ZaddyHaze/HAZE/brand/stills/living-lattice-etsy-1x1.png

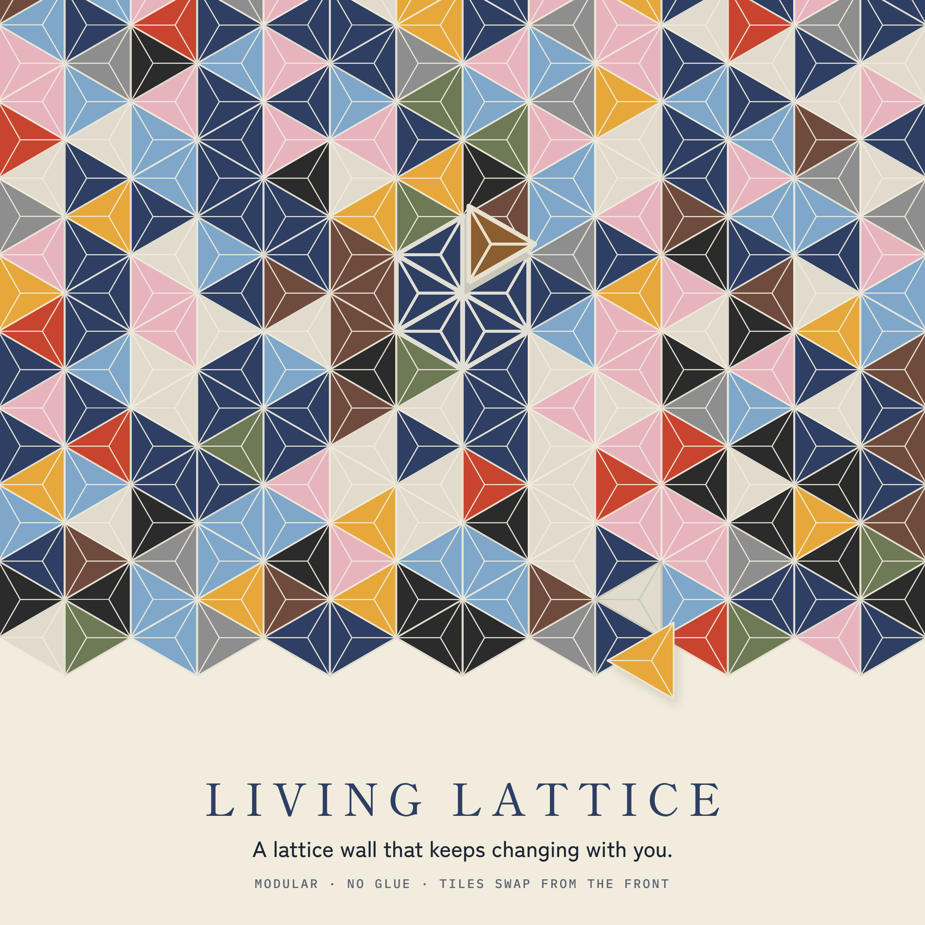
brand/stills/living-lattice-etsy-1x1.png
