ZaddyHaze/HAZE/HANDOFF.md

# Handoff to Cursor — state as of Oct 17, 2026

Brand: **Living Lattice**, designed by Travis Hergenreder. Start with `AGENTS.md`, then `docs/DESIGN.md`. Run `npm test` first: 101 checks should pass.

## What's done
- Builder (`index.html` + `src/engine.js`) with a simple panel of 7 choices and everything else under Advanced.
- Zigzag swappable tiles and half-lap "one solid panel" seams. All joints snap-fit; no glue.
- Round wall pucks hidden behind tile hubs. Frame standoffs hidden behind the frame bar (one per ~300 mm). Slotted shims.
- Optional floating frame with an LED channel (Advanced, or the "LED backlight" checkbox).
- Every part prints without supports, and no hardware shows from the front (enforced by `test/printability.test.js`).
- Test kit: lap, pegs, pucks, frame/standoff snap, shims.

- Per-tile inserts (asanoha / mitsukude / open), snap-in colored backers, color preview and two-color (AMS) export.

- Photo designer (first version): upload a picture, each triangle cell snaps to the nearest of 10 stocked colors (CIELAB), preview + chip counts + numbered `cell_color_map.svg` in the export.

- **Furniture fit** (Oct 17): "Made for" presets in the builder: cube-shelf insert (KALLAX-type, hidden spring clips, `mount = fit`) and headboards (Twin/Full/Queen/Cal King/King × 610 mm).
- **Cell accessories** (Oct 17, `src/accessories.js` + `npm run accessories`): magnet chip (sealed 8 × 2 mm magnet), cleat plug (universal accessory mount), bud vase holder (16 × 100 mm glass tube). Not in the builder yet.
- **Test kit as one Bambu project** (`npm run kit` → `cli/test-kit-3mf.js` + `cli/threemf.js`): 3 plates, named objects, magnet pause preset.
- **Panel 3MF export** (`cli/threemf.js`): CLI `generate.js` and the builder Export zip write `living_lattice_WxH.3mf` — 0.2 mm layers, 4 walls, mouse-ear brim on tiles/frame/backers, no brim on hardware, supports off, XY compensation 0. One plate per large part; hardware packed when it fits. Skip with `--no-3mf`. Letter-page wall templates when wall mount is on.
- **Website** (`site/`): `site/index.html` is the landing page (one `SITE_CONFIG` block at the top for email, checkout links, builder and starter URLs). `npm run build-site` writes `site/builder.html` (this builder as one file, with preset chips + LED halo on the stage). Builder opens on a preset from links or the chip bar: `builder.html?preset=queen` (also `#queen` inside a claude.ai artifact) — wall-led, cube, twin, full, queen, cal, king, starter. Starter pack: `site/living-lattice-starter-600x400.zip` (regenerate with `node cli/generate.js --set W=600 --set H=400 --set pat=asanoha --out out/living-lattice-600x400`).
- **Brand** (`brand/`): vector logo (stacked, horizontal, mark, one-color indigo/white, favicon + PNGs) and `animate.py`, which renders the logo-unfold video from the real geometry. Colors: indigo #2E3F63, wood #8A5E2E, paper #F1ECDD. Display font Shippori Mincho. Background everywhere is kinari #F1ECDD (design system tokens v3). Logo SVGs are outlined: `python3 brand/make_logos.py`. Social/listing stills: `python3 brand/stills_field.py stills/field-4x5.png 1080 1350 980 900` and `... field-1x1.png 2000 2000 1440 1380 0.8`, then `node brand/stills.js`.
- **Pattern-aware seams** (this branch): `latticeFit` + `assignCellTiles` so edges start on full/half cells and seams follow each pattern's grain.
- **Landing favicons + OG** (Oct 20): `site/favicon.svg` / `-32.png` / `-180.png` and `site/og-image.png` (1200×630, mark + wordmark on kinari). `og:image` is still a relative URL — make it absolute once the domain is live.

**Not in this HAZE clone yet** (described in a parallel HANDOFF at 106 checks / v0.16): cell paint + night LED wash in the builder, `design-system/`, `src/threemf-core.js` shared writer, panel-fit kit UI. Port those with tests when Travis wants them here — do not paste a second builder.

## Product direction (Oct 17): modular cells
Base model = frame + bare triangle grid in one color. Every cell takes a snap-in **backer chip** (color) and an **insert piece** (asanoha / mitsukude / none), placed from the front, so customers redesign their own panel. Sold as kits: color-sorted bags + numbered map (paint-by-numbers). Add-ons priced separately.
- `cli/cell-coupon.js` makes the fit test (two-cell base with a stepped back ledge, chips + inserts at tight/medium/snug). **Next geometry task once Travis reports the winning fit:** build the cell system into the engine (ledge in every cell of bare tiles, per-cell chip and insert exports cut to partial edge cells, per-cell placement from the photo designer), replacing the per-tile backer.
- Risks: ~350 cells per Classic = up to ~700 small parts (kit, not pre-assembled); low resolution (bold simple images only); customer-image copyright (terms + refusal of brands/characters).

## Ground rules from Travis (in addition to AGENTS.md)
- **One codebase.** Don't paste in builders or engines generated by other AI tools; earlier ones were truncated, reintroduced visible wall plates and dropped the tests. Port an idea into this engine with a test instead.
- Never call the product "traditional Japanese kumiko". Patterns are centuries-old Japanese designs; the system is original.
- Marketing and listing images must show real printed parts. AI imagery is mood only.
- "KALLAX" only as "fits IKEA KALLAX", never in a product name.

## Waiting on Travis
- Cell coupon + accessories test results (`living-lattice-test-kit.3mf`, plates 1–3): winning fit for chips, magnet chips and cleat plugs; does the vase hang flat.
- Business email/domain and license checkout links → `SITE_CONFIG` in `site/index.html`.
- Accessory test print (`accessories` zip): which fit each part likes, does the vase hang flat. Then: add accessory cells to the per-cell editor (pick a cell → magnet / vase), with counts in the export.
- Real KALLAX opening measurement (preset assumes 335 mm; clips tolerate about ±1 mm per side).
- Test kit printed Oct 17: **3 dots (0.15 mm) and 4 dots (0.20 mm) fit best**. Default stays 3 dots (0.15). 4 dots is the fallback if full-size tiles press on too tight. Don't go above 0.20: the lap snap barb needs fc ≤ 0.20.
- Trademark/domain check for "Living Lattice" before the name goes on anything printed.

## Next tasks, in order
0. **Accessory cells in the builder** once the cell system lands: per-cell type (chip / magnet / cleat plug), vase holders counted per cleat plug, magnet count + pause height in the README. Only on 40/60 mm cells, unrotated grid.
1. ~~**3MF export**~~ **done** — `cli/threemf.js` (CLI + web): full panel `living_lattice_WxH.3mf` with per-object settings (0.2 mm / 4 walls / brim_ears on tiles+frame / no_brim on hardware). Also used by `npm run kit`.
2. **Hub dots**: the hubs over the pucks show as round dots on the front (most visible on the square grid). Either place sockets only at vertices where the lattice is already dense, or make the hubs a deliberate design detail.
3. **Sakura and goma inserts**: only from a verified construction reference (photo or diagram from Travis, or a kumiko book).
4. **Frame shapes**: round and hexagon frames (see chat notes): clip lattice to the shape, curved/angled frame pieces split to the bed.
5. **Density zones**: large and small cells in one frame, 2:1 ratio only, so lines carry through.
6. **Inward-facing LED channel** (second cove option), parked by Travis.
7. **Slotted puck/standoff holes** (±2 mm drilling tolerance).
8. **Backlight seam glow**: seam gaps may glow under LED light. Test on a printed pair before changing geometry.

Keep `npm test` green. Add a test for every new mechanism.
