ZaddyHaze/HAZE/brand/mark-1024.png

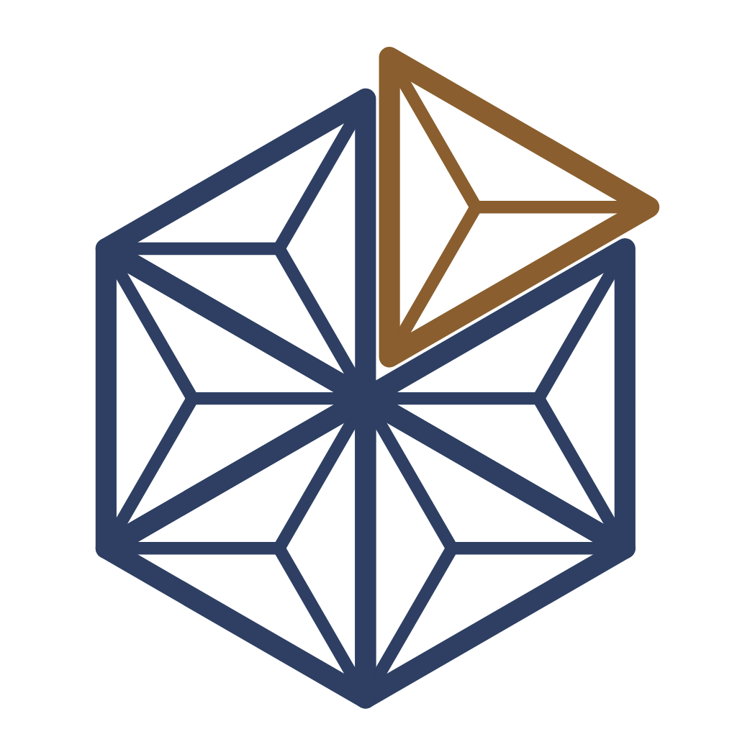
brand/mark-1024.png
