ZaddyHaze/HAZE/brand/stills/field-1x1.png

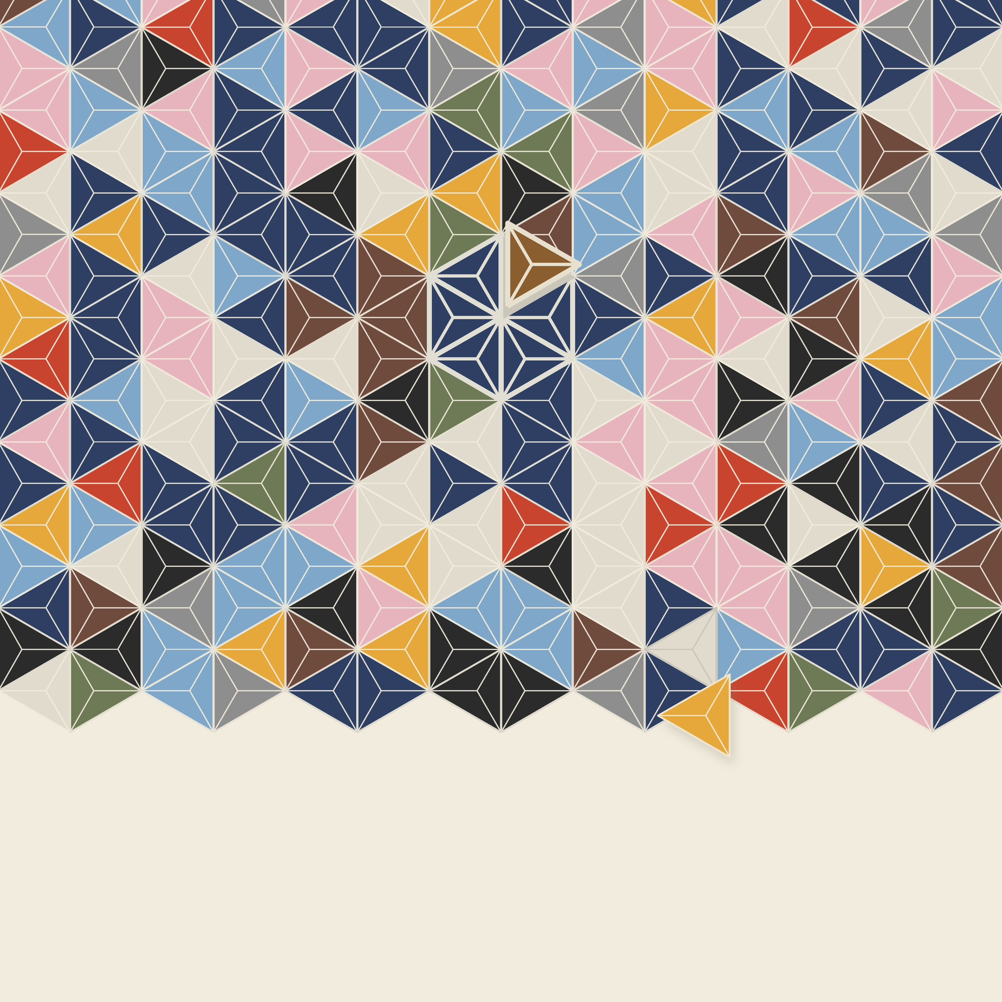
brand/stills/field-1x1.png
