ZaddyHaze/HAZE/brand/stills/field-4x5.png

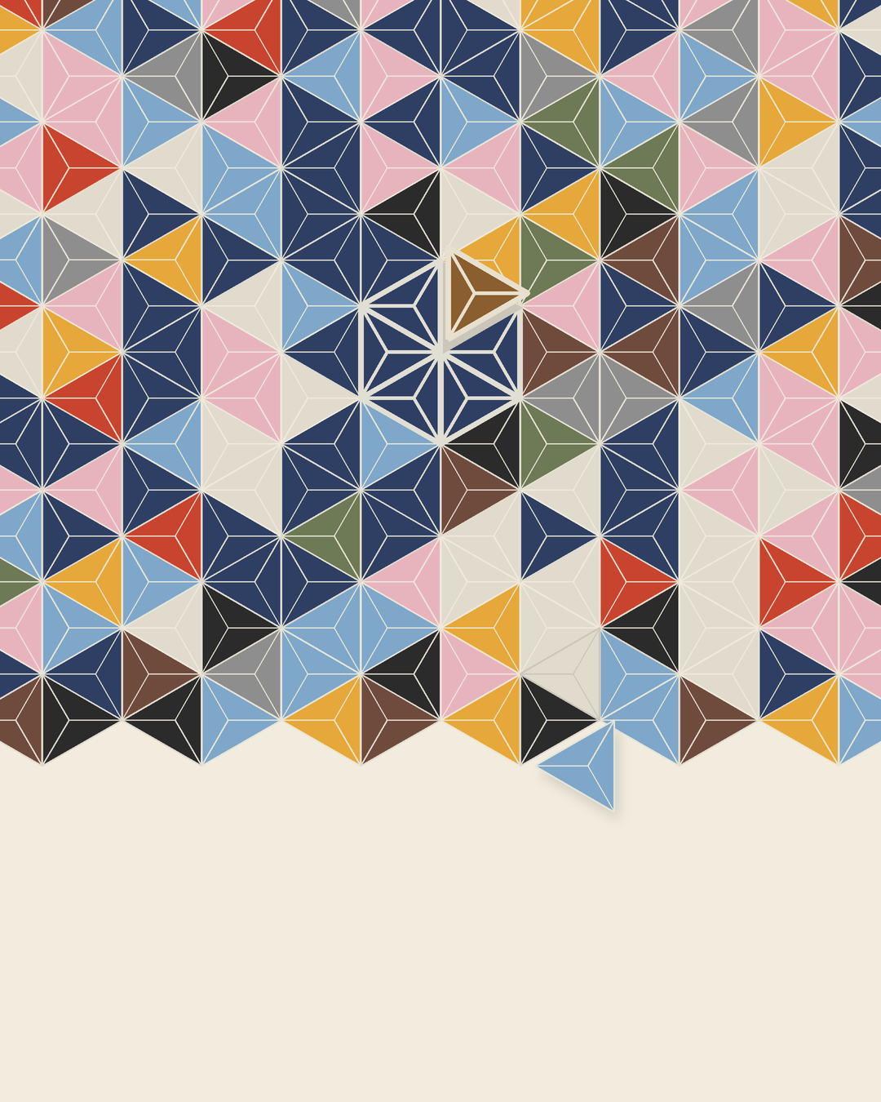
brand/stills/field-4x5.png
