ZaddyHaze/HAZE/brand/stills/living-lattice-instagram-4x5.png

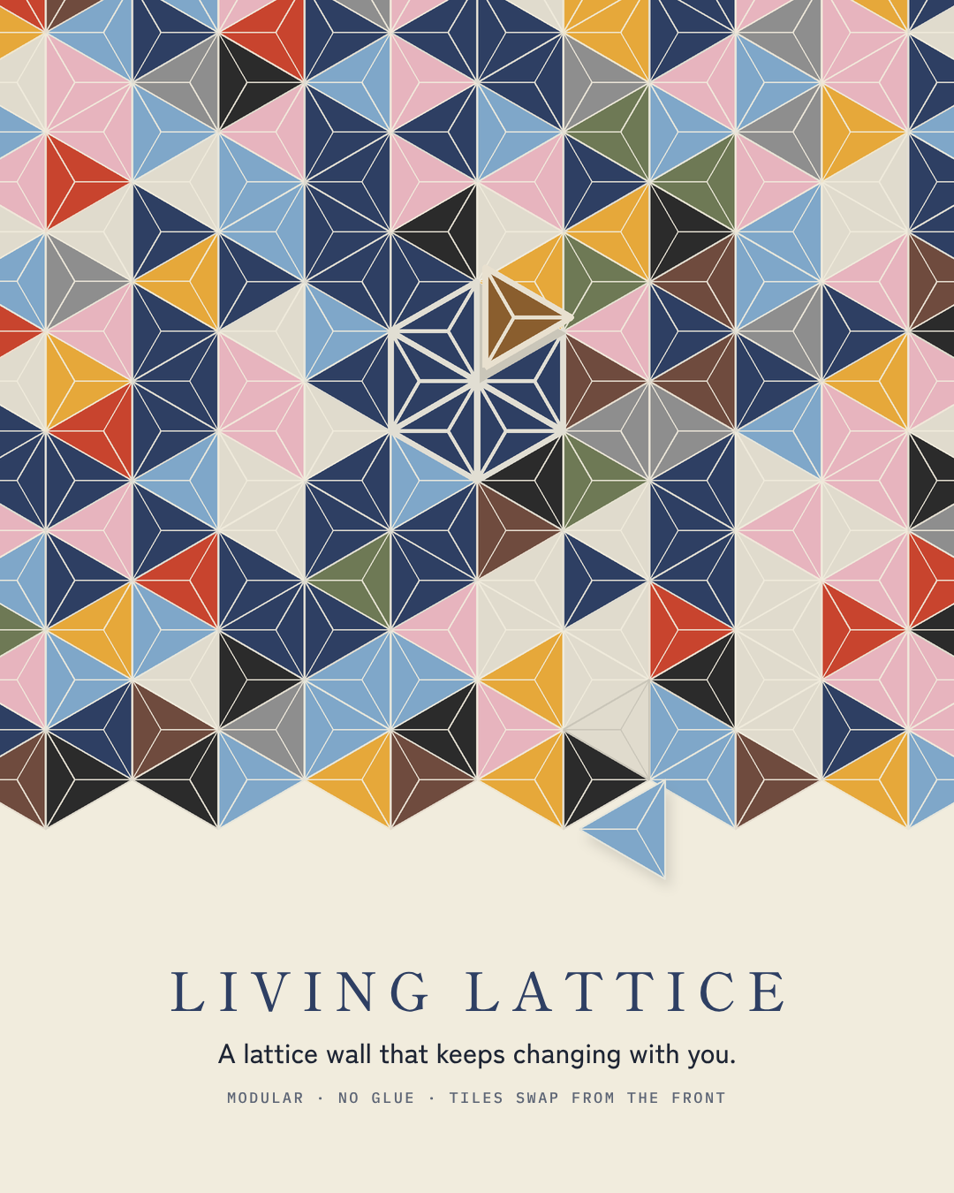
brand/stills/living-lattice-instagram-4x5.png
