ZaddyHaze/HAZE/site/og-image.png

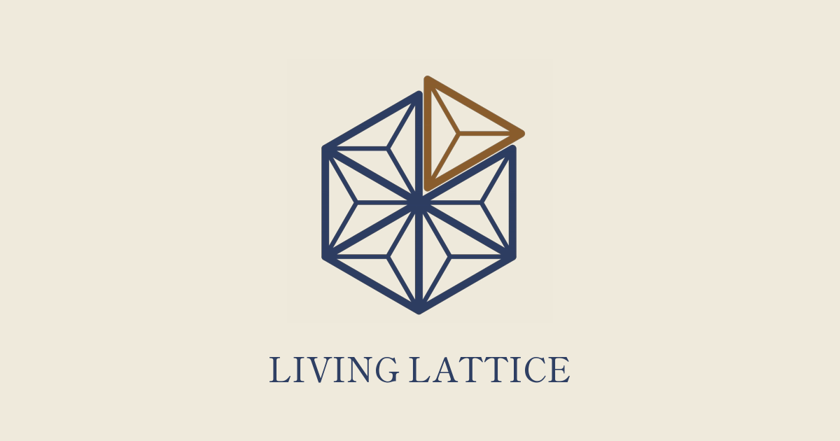
site/og-image.png
