ZaddyHaze/HAZE/examples/living-lattice-accent/border_l.stl

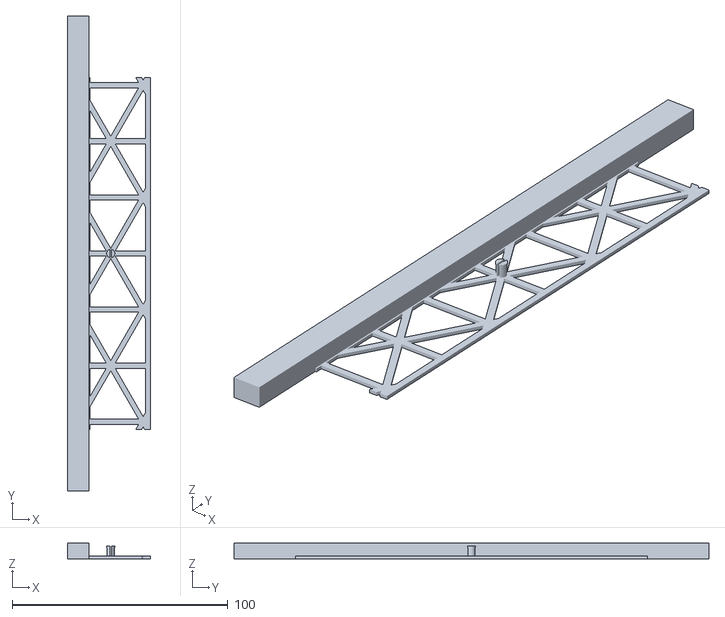
[picture p7: CAD file, 2026-10-17]
examples/living-lattice-accent/border_l.stl
38.4 x 220.0 x 7.20
