ZaddyHaze/HAZE/examples/living-lattice-accent/border_t2.stl

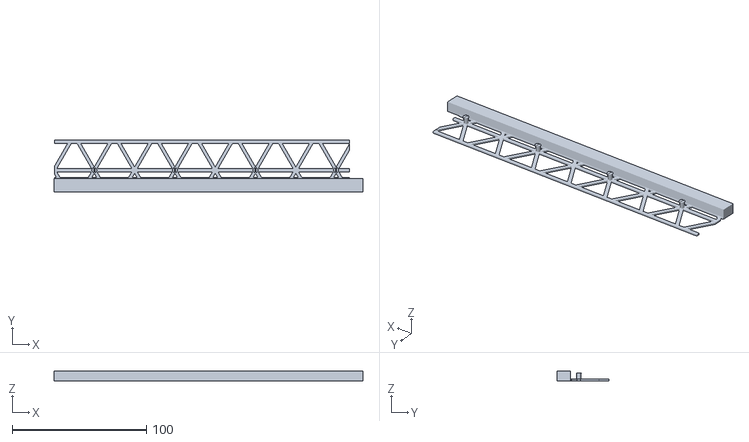
[picture p8: CAD file, 2026-10-17]
examples/living-lattice-accent/border_t2.stl
230.0 x 38.4 x 7.20
