ZaddyHaze/HAZE/examples/living-lattice-accent/frame_standoffs_x6.stl

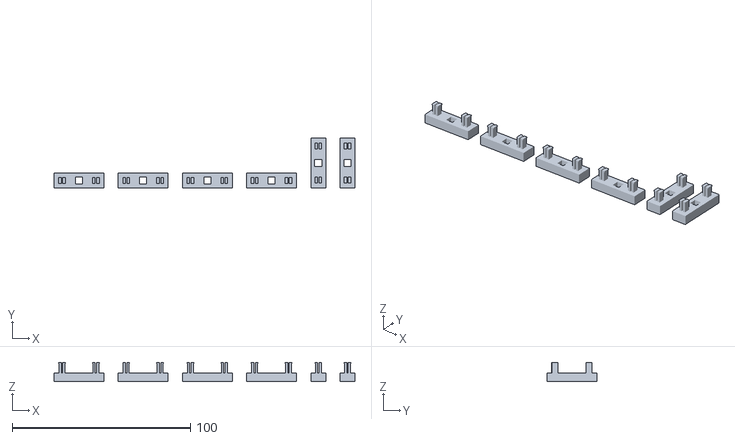
[picture p9: CAD file, 2026-10-17]
examples/living-lattice-accent/frame_standoffs_x6.stl
168.8 x 28.0 x 10.9
