ZaddyHaze/HAZE/examples/living-lattice-accent/living_lattice_460x240.3mf

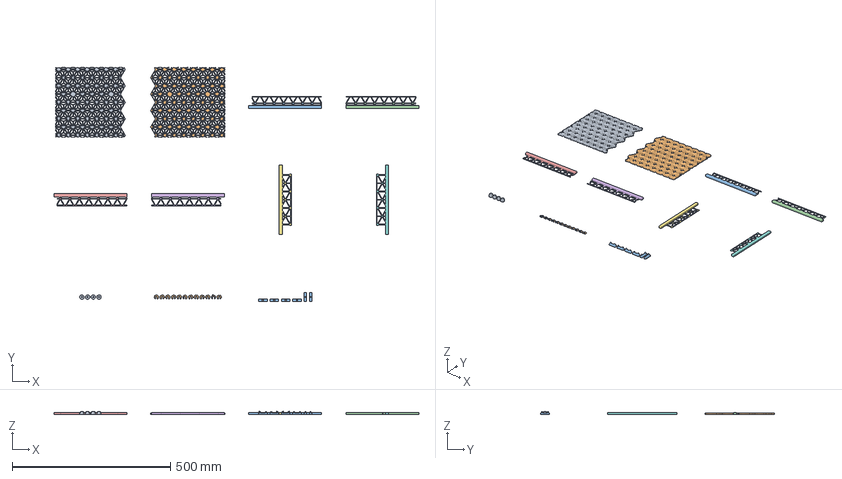
[picture p10: CAD file, 2026-10-17]
examples/living-lattice-accent/living_lattice_460x240.3mf
1151.6 x 738.4 x 10.9 mm
tile_A1
tile_A2
border_t1
border_t2
border_b1
border_b2
border_l
border_r
wall_pucks_x4
puck_shims_4_each_0.4-0.8-1.2mm
frame_standoffs_x6
