ZaddyHaze/HAZE/examples/living-lattice-accent/puck_shims_4_each_0.4-0.8-1.2mm.stl

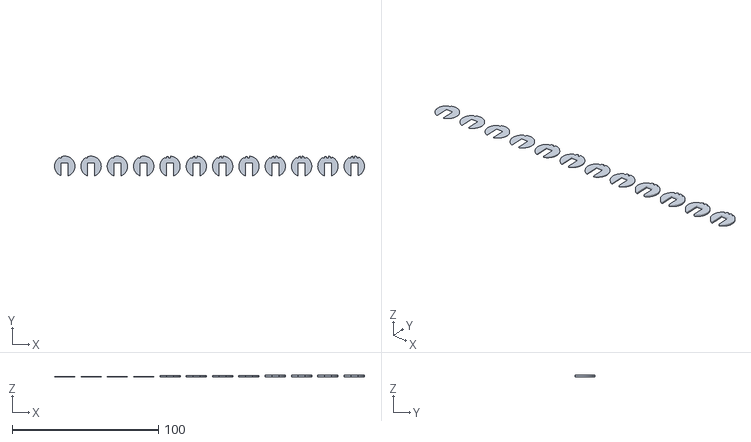
[picture p11: CAD file, 2026-10-17]
examples/living-lattice-accent/puck_shims_4_each_0.4-0.8-1.2mm.stl
212.0 x 13.6 x 1.20
