ZaddyHaze/HAZE/examples/living-lattice-accent/tile_A1.stl

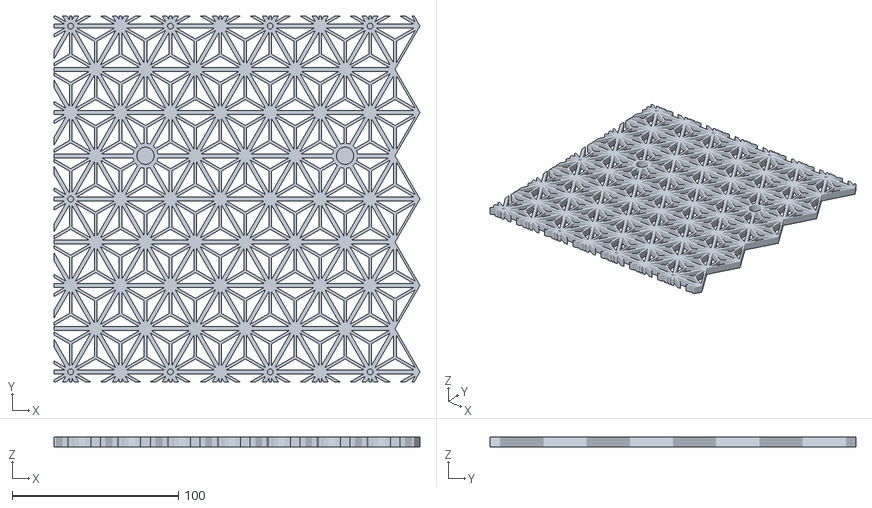
[picture p12: CAD file, 2026-10-17]
examples/living-lattice-accent/tile_A1.stl
220.0 x 220.0 x 6.00
