ZaddyHaze/HAZE/examples/living-lattice-accent/wall_pucks_x4.stl

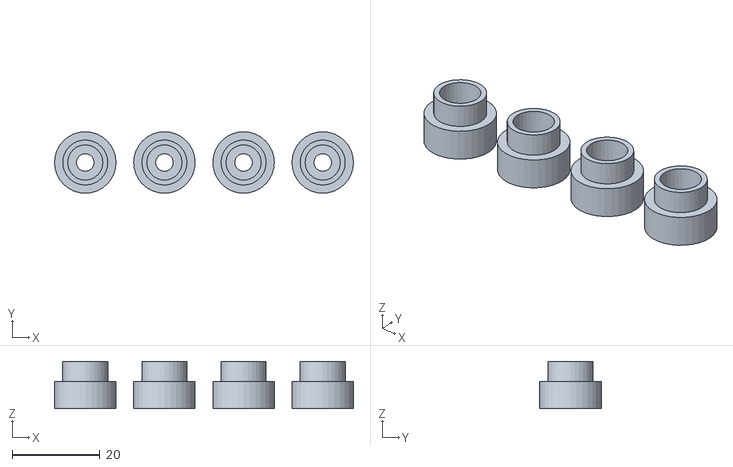
[picture p13: CAD file, 2026-10-17]
examples/living-lattice-accent/wall_pucks_x4.stl
68.0 x 14.0 x 10.7
