ZaddyHaze/HAZE/examples/living-lattice-accent/tile_A2.stl

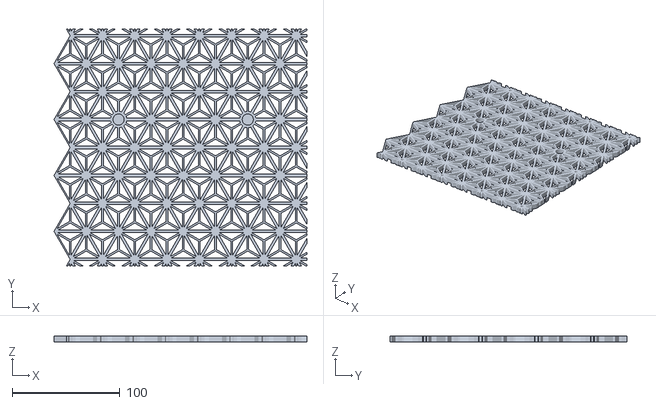
[picture p14: CAD file, 2026-10-17]
examples/living-lattice-accent/tile_A2.stl
235.0 x 220.0 x 6.00
