ZaddyHaze/HAZE/(list of files, cad)

Other CAD files:
examples/living-lattice-accent/border_b2.stl
examples/living-lattice-accent/border_r.stl
examples/living-lattice-accent/border_b1.stl
examples/living-lattice-accent/border_t1.stl
