ZaddyHaze/HAZE/examples/living-lattice-accent/wall_template_letter_pages.pdf

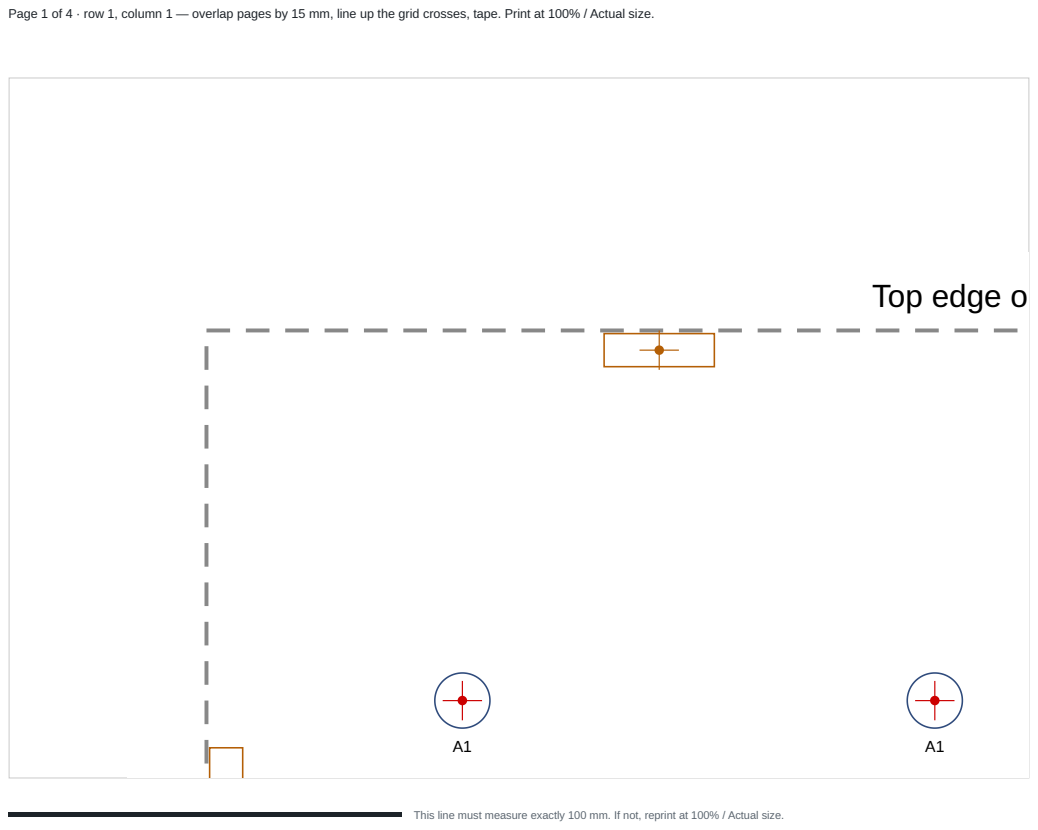
[picture p15: page 1]
Top edge o

Page 1 of 4 · row 1, column 1 — overlap pages by 15 mm, line up the grid crosses, tape. Print at 100% / Actual size.

This line must measure exactly 100 mm. If not, reprint at 100% / Actual size.

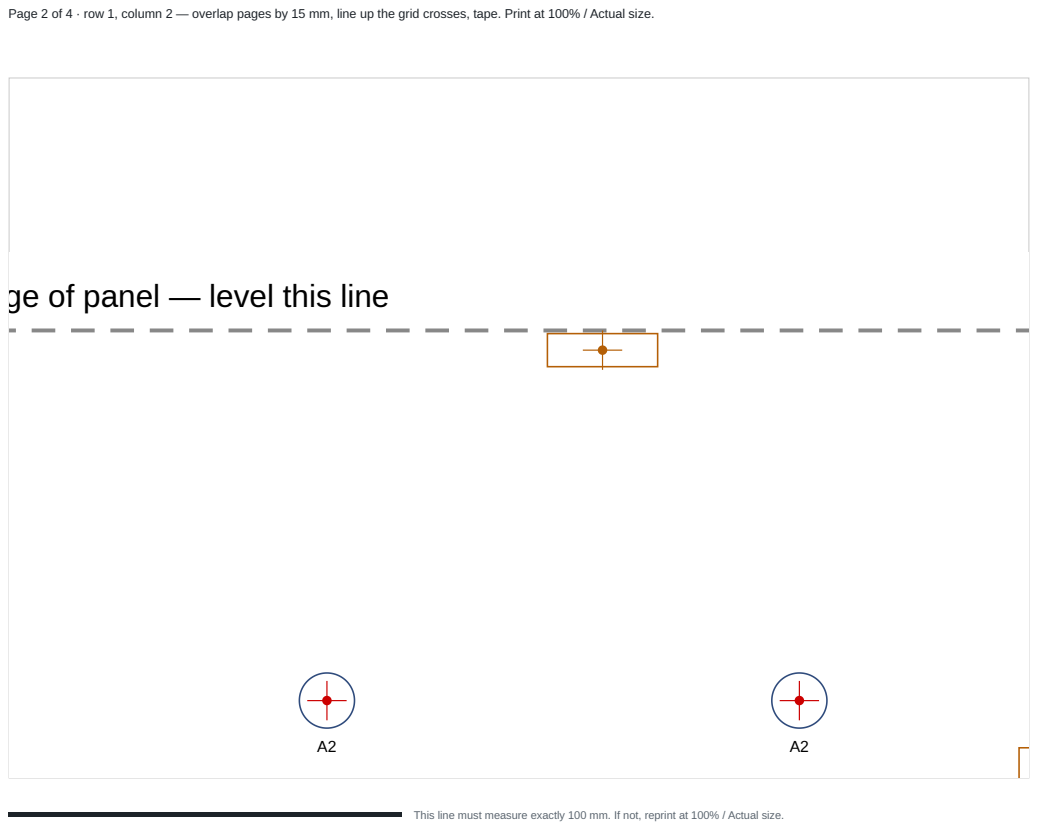
[picture p16: page 2]

Page 2 of 4 · row 1, column 2 — overlap pages by 15 mm, line up the grid crosses, tape. Print at 100% / Actual size.

ge of panel — level this line

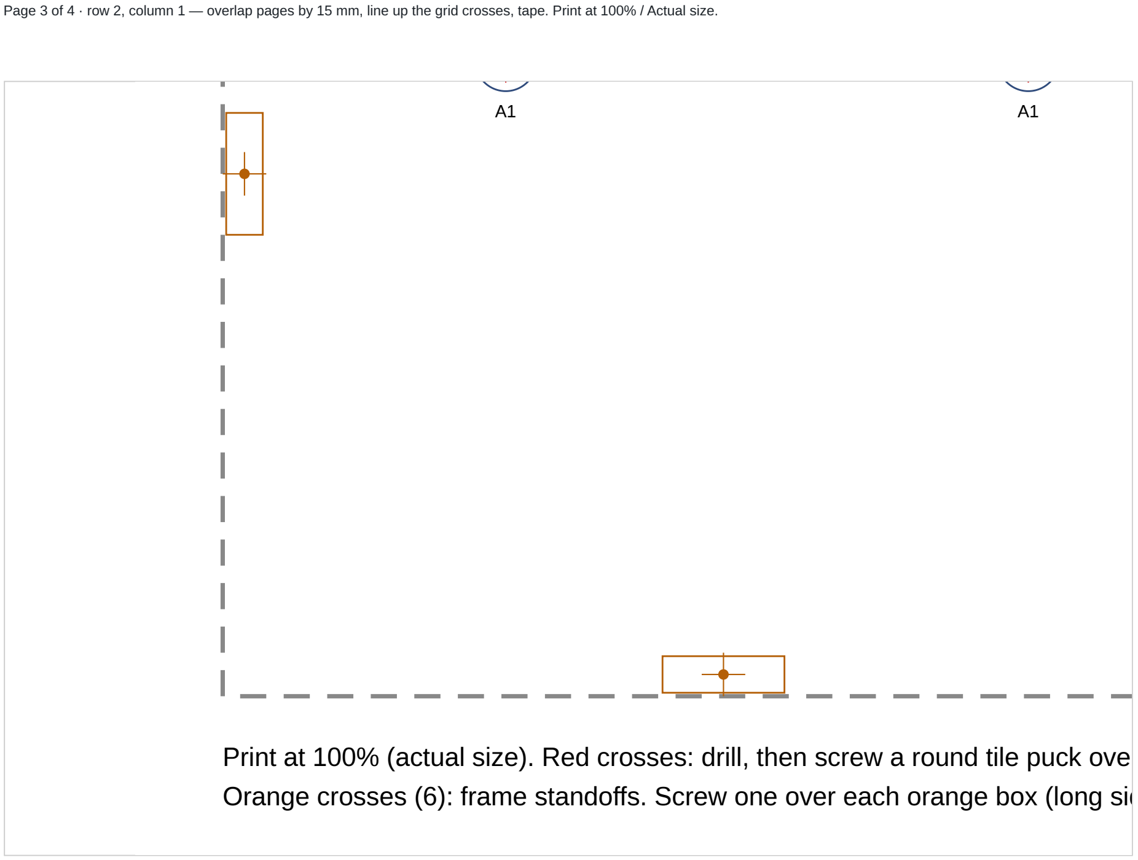
[picture p17: figure]

# Print at 100% (actual size). Red crosses: drill, then screw a round tile puck ove Orange crosses (6): frame standoffs. Screw one over each orange box (long sid

Page 3 of 4 · row 2, column 1 — overlap pages by 15 mm, line up the grid crosses, tape. Print at 100% / Actual size.

A2 | A2

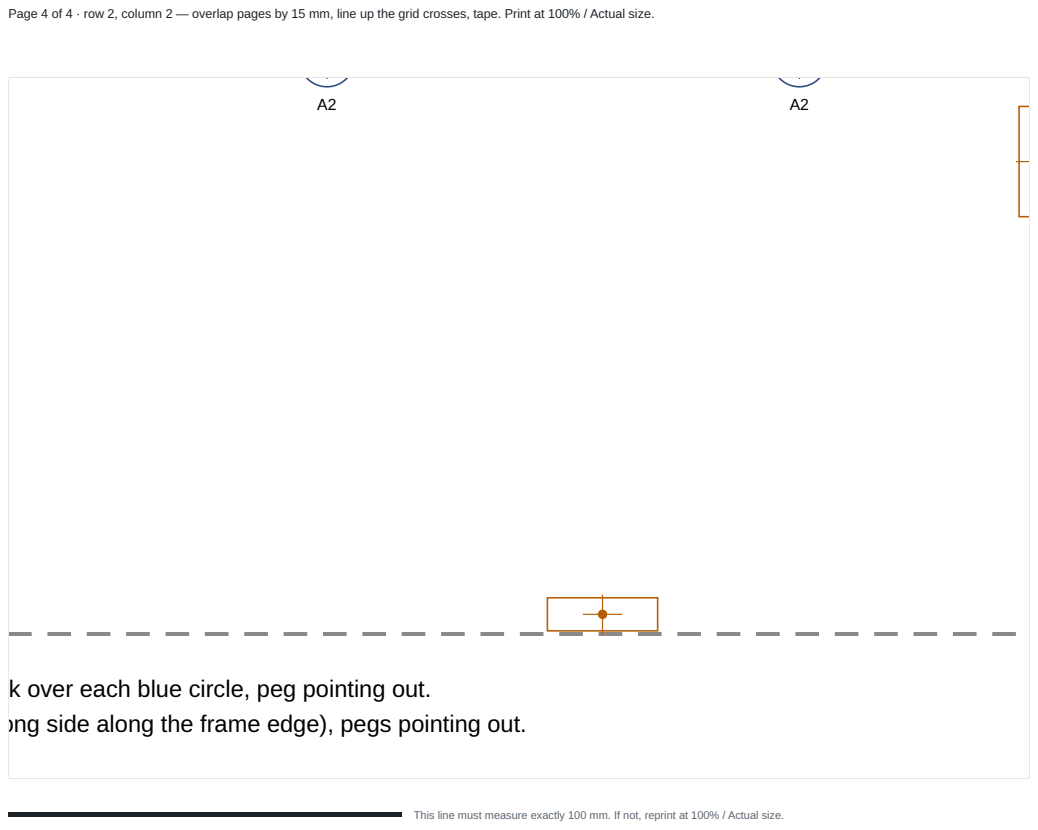
[picture p18: page 4]

Page 4 of 4 · row 2, column 2 — overlap pages by 15 mm, line up the grid crosses, tape. Print at 100% / Actual size.

k over each blue circle, peg pointing out.
ong side along the frame edge), pegs pointing out.
