ZaddyHaze/HAZE/(commit log)

2026-10-16 Add Bambu Studio 3MF export with per-object print settings
    CLI generate now writes kumiko_WxH.3mf alongside STLs: 0.2 mm layers,
    5 mm outer brim, and wall loops sized so grid/infill bars print solid.
2026-10-16 Include Bambu .3mf in the web Export zip
    Share cli/bambu-3mf.js with the browser (globalThis.Bambu3mf) so the
    page zip ships the same per-object print settings as the CLI.
2026-10-17 Merge updated kumiko-panel (printability, round pucks) with 3MF export
    Bring in the newer panel sources (hidden round pucks, shims, standoffs,
    printability tests, craftsman/history skills) and keep Bambu Studio
    .3mf export on both CLI and web zip.
2026-10-17 Merge Living Lattice update; 3MF matches HANDOFF print settings
    Bring in simplified UI, Living Lattice branding, and ~300 mm standoff
    spacing. 3MF export now uses 0.2 mm / 4 walls / mouse-ear brim on
    tiles+frame, no brim on hardware, supports off, XY compensation 0.
2026-10-17 Add letter-page wall templates and living-lattice-accent example
    The accent panel export included wall_template_letter_pages.pdf. CLI now
    tiles the wall template onto US Letter landscape pages (15 mm overlap)
    via headless Chrome; the web zip ships the print HTML. Example panel
    regenerated with living_lattice_460x240.3mf.
    [border_b1.stl, border_b2.stl, border_l.stl, border_r.stl, border_t1.stl, border_t2.stl, frame_standoffs_x6.stl, living_lattice_460x240.3mf]
2026-10-18 Ship Living Lattice site with canvas hero and Bambu 3MF export
    Replace the landing page with the production Living Lattice marketing
    page (60fps hero animation, Made-for presets, specs, commercial license
    modal) while keeping SITE_CONFIG for builder/starter/checkout URLs.
    Canonical 3MF writer lives in cli/threemf.js with HANDOFF per-object
    settings; CLI generate and web exportZip both emit panel .3mf projects.
    build-site inlines threemf + letter-pages + engine into site/builder.html.
2026-10-18 Make zigzag seams follow each pattern's lattice grain
    Stop using one rectangular cell cut for every pattern. Triangle patterns
    keep horizontal joins on base edges; kaku snaps to axis-aligned grid
    lines; kikkō drops phantom triangle half-bars so hex infill carries the
    join; hishi keeps panel-space tiles so diamond stairsteps still fit the
    bed. Add geometry coverage for the new assignCellTiles rules.
2026-10-18 Align lattice to frame so edges start on full or half cells
    Stop centering the pattern on the panel — that left ~1 mm triangle
    slivers along the frame. latticeFit snaps each axis to an integer
    count of full or half pitches inside the opening; leftover becomes a
    tiny empty margin instead of a printed fragment. Drop cells whose
    visible fraction is under 40%, and only place frame pegs at vertices
    with enough neighboring cells for a complete hub ring.
2026-10-19 Ship regenerated 600×400 starter and preset chips on the real builder
    Regenerate the starter pack from the pattern-aware / edge-aligned engine
    (all-plates.3mf + STLs). Port landing-page preset chips and LED stage halo
    into index.html instead of replacing the printable builder.
2026-10-20 Wire Living Lattice favicons and OG image on the landing page
    Copy brand mark favicons into site/, add social-share meta tags, and
    ship a 1200×630 kinari og-image. Note parallel-session features not yet
    ported into this clone.
